juchong/ADIS16448-RoboRIO-Teensy-Interface/PCB/ADIS16448 RoboRIO Teensy MXP Breakout RevA BRD.pdf

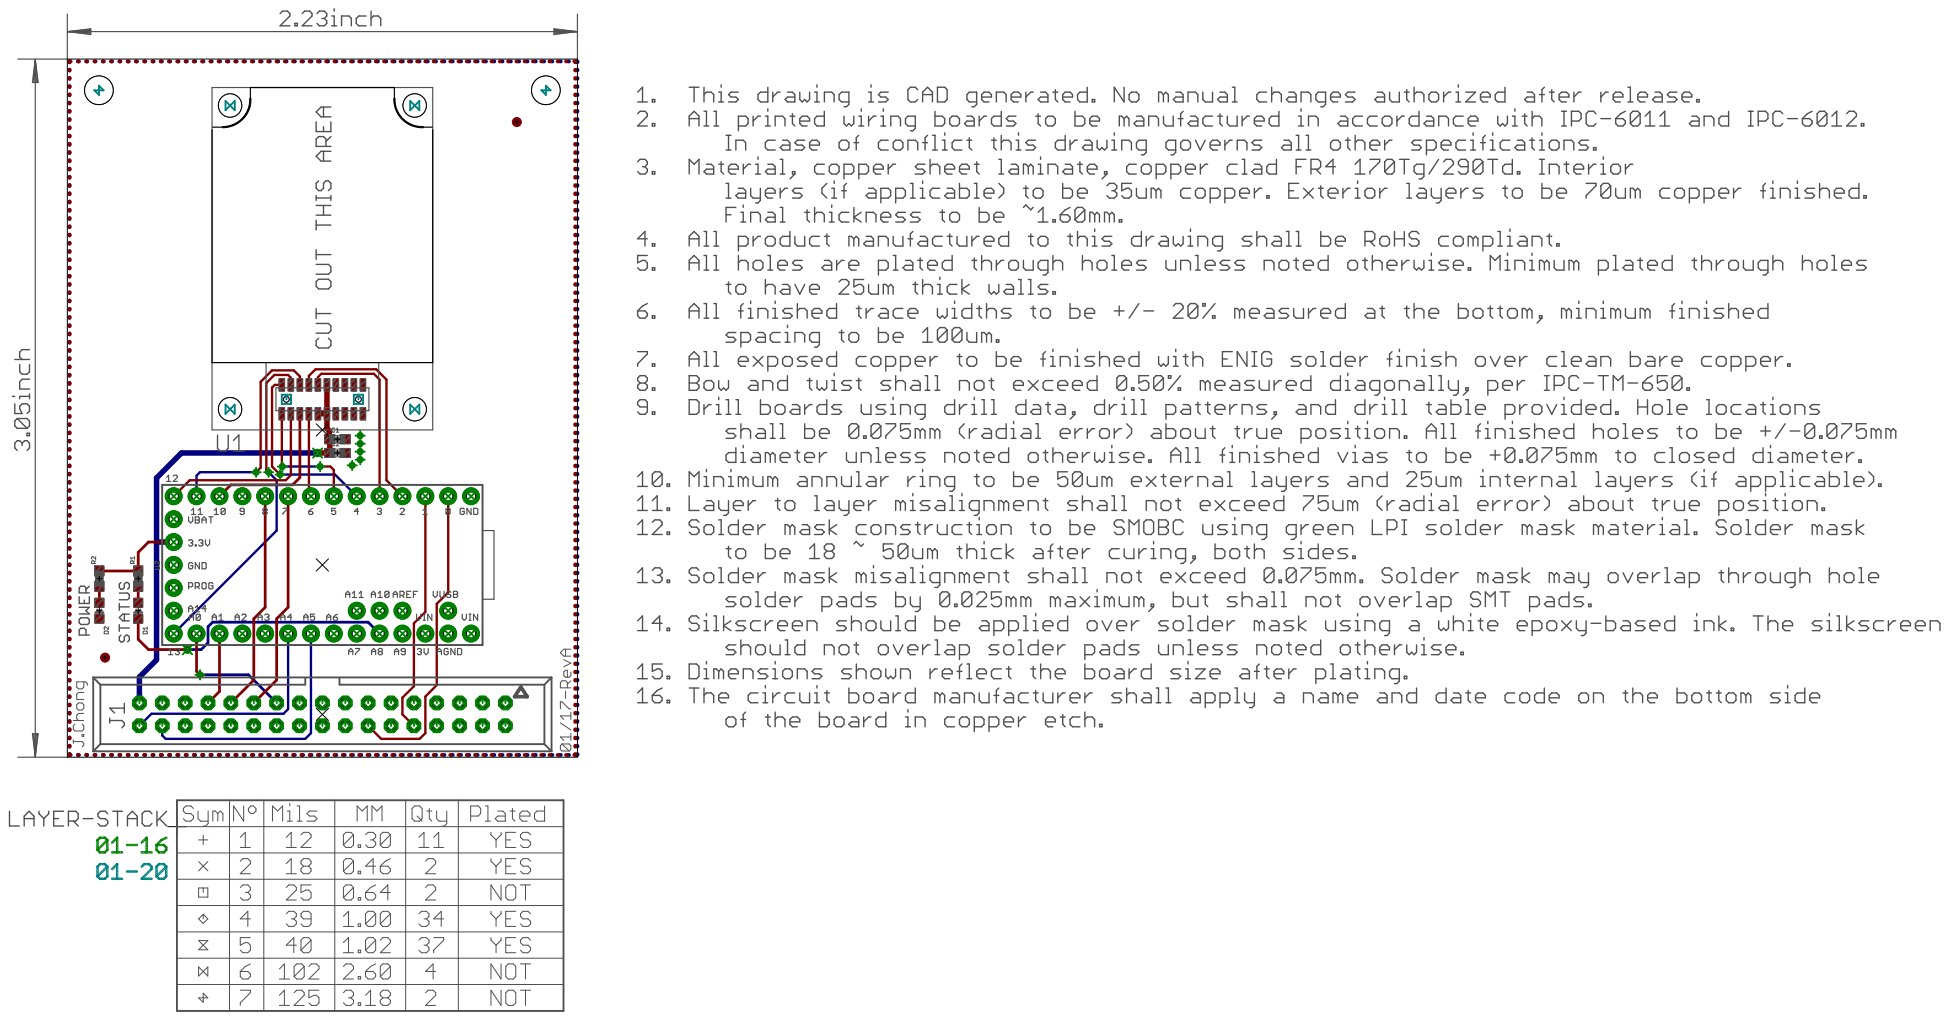
[picture p1: page 1]
