juchong/ADIS16448-RoboRIO-Teensy-Interface/PCB/ADIS16448 RoboRIO Teensy MXP Breakout RevA SCH.pdf

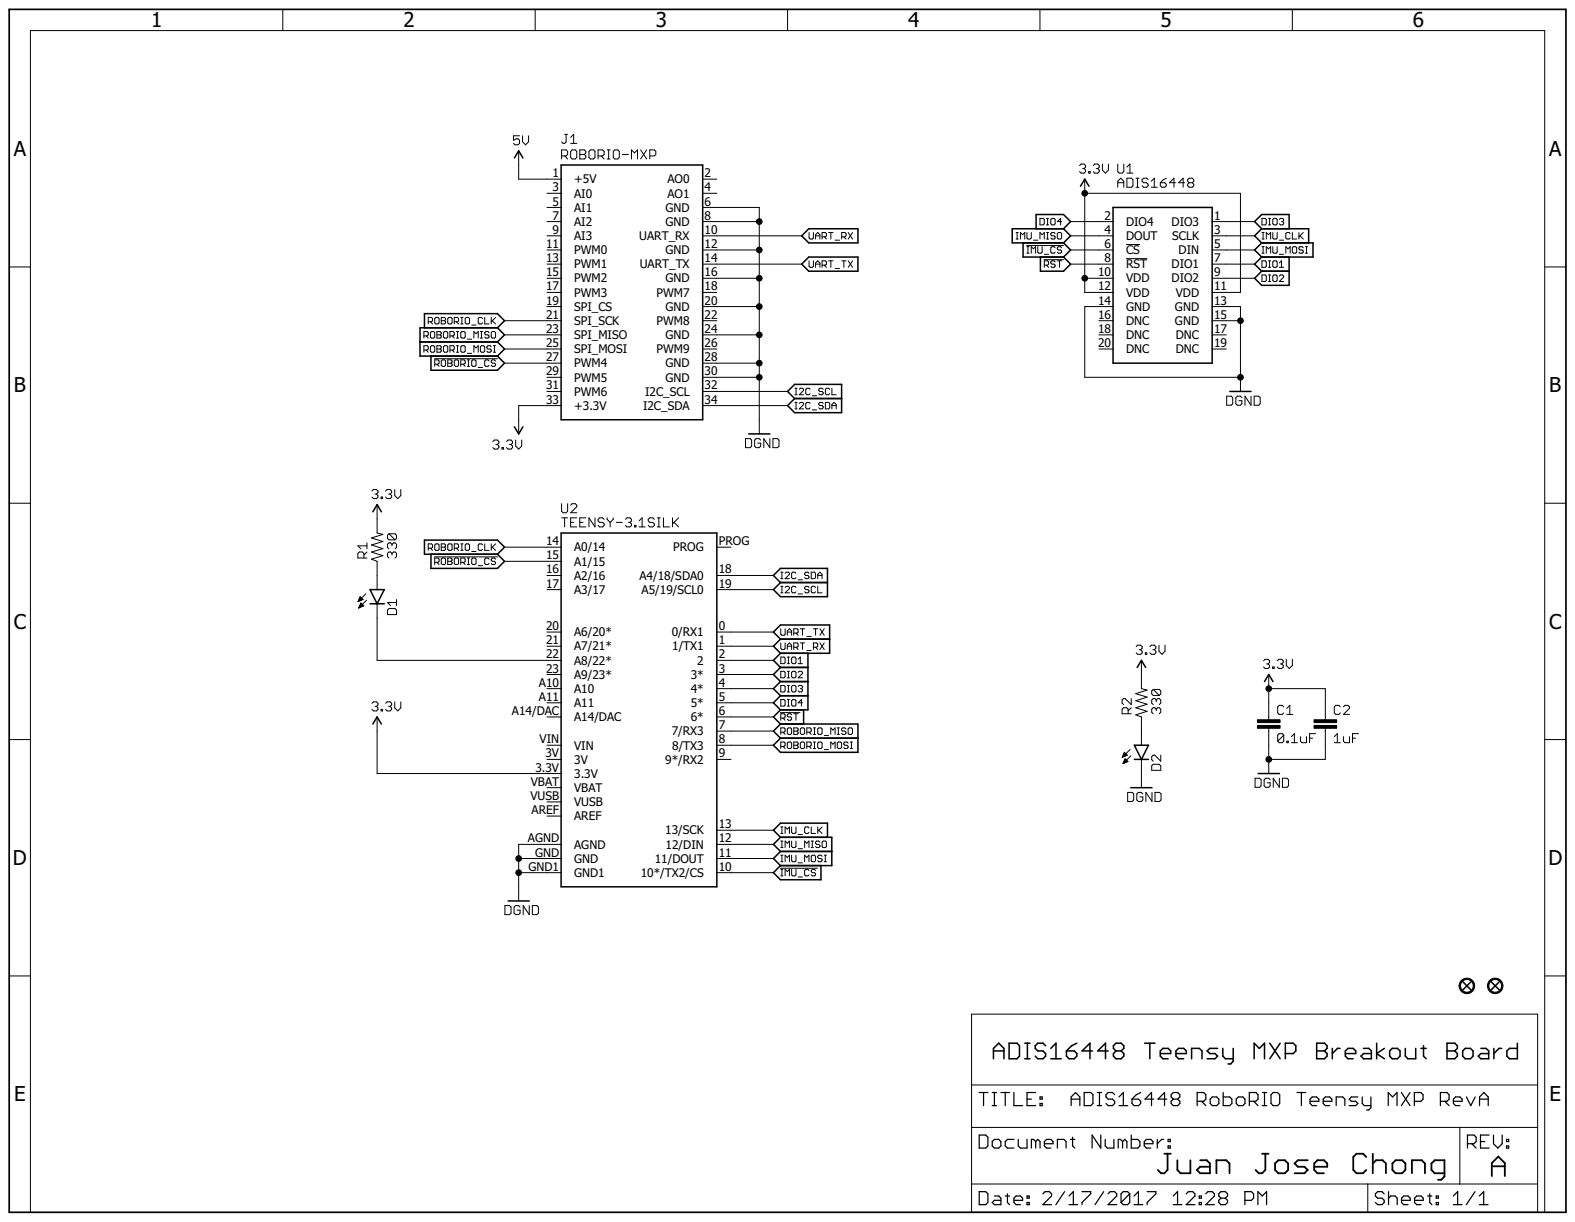
[picture p2: page 1]
