juchong/ADIS16448-RoboRIO-Teensy-Interface/Arduino/ADIS16448_RoboRIO_Teensy_Interface/ADIS16448_RoboRIO_Teensy_Interface.ino

////////////////////////////////////////////////////////////////////////////////////////////////////////
//  February 2017
//  Author: Juan Jose Chong <juan.chong@analog.com>
////////////////////////////////////////////////////////////////////////////////////////////////////////
//  ADIS16448_RoboRIO_Teensy_Interface.ino
////////////////////////////////////////////////////////////////////////////////////////////////////////
// 
//  This Arduino project interfaces an ADIS16448 IMU to a RoboRIO via UART (Serial1). 
//  The Arduino software provides a means of extracting IMU data while precicely controlling 
//  software timing. In addition, this software greatly reduces the processing overhead
//  required to acquire and calculate heading using only the RoboRIO. Gyro offset calibration
//  and heading reset are currently supported using ASCII serial commands sent via serial. 
//
//  This library relies on the ADIS16448 Arduino Teensy library which may be found
//  here: https://github.com/juchong/ADIS16448-Arduino-Teensy
//
//  It also relies on the Madgwick AHRS implementation which may be found here:
//  https://github.com/arduino-libraries/MadgwickAHRS
//	
//	Saving data to EEPROM relies on the EEPROMex library found here:
//	https://github.com/thijse/Arduino-EEPROMEx
//
//  This project has been tested on a PJRC 32-Bit Teensy 3.1/3.2 Development Board, 
//  but should be compatible with any other embedded platform with some modification.
//
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
//  Pinout for a Teensy 3.1/3.2 Development Board
//  RST = D6
//  SCK = D13/SCK
//  CS = D10/CS
//  DOUT(MISO) = D12/MISO
//  DIN(MOSI) = D11/MOSI
//  DR = D2
//	UART RX = D0
//	UART TX = D1
//
////////////////////////////////////////////////////////////////////////////////////////////////////////
#include <ADIS16448.h>
#include <MadgwickAHRS.h>
#include <SimpleGyroIntegrator.h>
#include <SPI.h>
#include <EEPROMex.h>

// Uncomment to enable debug mode and print additional data to the serial port
//#define DEBUG

// Uncomment to overwrite garbage data in EEPROM with 0's
//#define FIRSTRUN

// Change printing from Serial1 (pins 0,1) to Serial (USB)
#define HWSERIAL Serial1

// Initialize data variables
int16_t *burstData;
float scaledData[11];
float pitch, roll, yaw, xdelta, ydelta, zdelta;
float datapacket1[17];
float datapacket2[17];
String serialpacket = "";
String separator = ',';
bool pingpong = true;
bool freezepingpong = false;

// Initialize calibration registers
float calDataX, calDataY, calDataZ = 0;
int calCounter = 0;

// EEPROM initialization
int calXloc = 0;
int calYloc = 5;
int calZloc = 10;

// Delay counter variable
int printCounter = 0;

// Z mounting orientation
bool initOrientation = true; //true = ZUP, false = ZDOWN

// Program flags
int internalCalFlag = 0;
int resetGyroFlag = 0;
bool teensyCalFlag = false;

// Delta time variables
unsigned long oldtime = 0;
unsigned long deltat = 0;

// Call ADIS16448 Class
ADIS16448 IMU(10,2,6); // Chip Select, Data Ready, Reset, Pin Assignments

// Call Madgwick Class
Madgwick AHRS;

// Call Gyro Integrator Class
SimpleGyroIntegrator SGI;

// Initial configuration and initialization
void setup() {
  HWSERIAL.begin(115200);
  IMU.configSPI();
  IMU.regWrite(MSC_CTRL, 0x06);  // Enable Data Ready, set polarity
  delay(20); 
  IMU.regWrite(SENS_AVG, 0x402); // Set digital filter
  delay(20);
  IMU.regWrite(SMPL_PRD, 0x01), // Disable decimation, enable internal sample clock
  delay(20);

// Overwrite EEPROM locations with 0's if this is the first time this code has run on this Teensy
  #ifdef FIRSTRUN
  	EEPROM.writeFloat(calXloc,calDataX);
    EEPROM.writeFloat(calYloc,calDataY);
    EEPROM.writeFloat(calZloc,calDataZ);
  #else
	calDataX = EEPROM.readFloat(calXloc);
	calDataY = EEPROM.readFloat(calYloc);
	calDataZ = EEPROM.readFloat(calZloc);
  #endif

  attachInterrupt(2, grabData, RISING); // Attach interrupt to pin 2. Trigger on the rising edge

}

// Read data from the sensor using burst mode, scale data, and update SGI/AHRS loops. Check for cal flags before reading next frame of data.
void grabData() {

	if (internalCalFlag == 1) {
		calibrateOffsetRegisterIMU();
	}

  // If a calibration is triggered, skip calculations and only service the calibration accumulation
	if (teensyCalFlag == true) {
	    calibrateTeensy();
	}
	else {
    burstData = IMU.burstRead(); // Read data and insert into array
    scaleData(); // Scale IMU data
    
    // Calculate delta time from last interrupt
    deltat = micros() - oldtime; 
    if (deltat > 2000) { // Check for micros() rollover and correct - dirty, but works
      deltat = 1025;
    }
    oldtime = micros(); // Update delta time variable for next iteration
    
    // Integrate gyros over time
    SGI.update(scaledData[0], scaledData[1], scaledData[2], deltat, resetGyroFlag); 
    
    // Compensate for IMU orientation (IMU is mounted upside-down when on an MXP breakout board)
    if (initOrientation == true) {
      AHRS.update(scaledData[0], scaledData[1], scaledData[2], scaledData[3], scaledData[4], scaledData[5], scaledData[6], scaledData[7], scaledData[8], deltat); // Calculage Madgwick AHRS
    }
    else {
      AHRS.update(scaledData[0], (scaledData[1] * -1), (scaledData[2] * -1), scaledData[3], (scaledData[4] * -1), (scaledData[5] * -1), scaledData[6], (scaledData[7] * -1), (scaledData[8] * -1), deltat); // Calculage Madgwick AHRS
    }
    
    // Gather packet data
    pitch = AHRS.getPitch();
    roll = AHRS.getRoll();
    yaw = AHRS.getYaw();
    xdelta = SGI.getX();
    ydelta = SGI.getY();
    zdelta = SGI.getZ();
    
    // PingPong between arrays such that data is not overwritten when writing 
    //  to the serial port while an ISR is generated. Disabling the ISR is not 
    //  acceptable because data would potentially be lost when ISRs weren't serviced.

    // Ping array
    if(pingpong == true) {
      datapacket1[0] = pitch;
      datapacket1[1] = roll;
      datapacket1[2] = yaw;
      datapacket1[3] = xdelta;
      datapacket1[4] = ydelta;
      datapacket1[5] = zdelta;
      datapacket1[6] = scaledData[0];
      datapacket1[7] = scaledData[1];
      datapacket1[8] = scaledData[2];
      datapacket1[9] = scaledData[3];
      datapacket1[10] = scaledData[4];
      datapacket1[11] = scaledData[5];
      datapacket1[12] = scaledData[6];
      datapacket1[13] = scaledData[7];
      datapacket1[14] = scaledData[8];
      datapacket1[15] = scaledData[9];
      datapacket1[16] = scaledData[10];
    }

    // Pong array
    if(pingpong == false) {
      datapacket2[0] = pitch;
      datapacket2[1] = roll;
      datapacket2[2] = yaw;
      datapacket2[3] = xdelta;
      datapacket2[4] = ydelta;
      datapacket2[5] = zdelta;
      datapacket2[6] = scaledData[0];
      datapacket2[7] = scaledData[1];
      datapacket2[8] = scaledData[2];
      datapacket2[9] = scaledData[3];
      datapacket2[10] = scaledData[4];
      datapacket2[11] = scaledData[5];
      datapacket2[12] = scaledData[6];
      datapacket2[13] = scaledData[7];
      datapacket2[14] = scaledData[8];
      datapacket2[15] = scaledData[9];
      datapacket2[16] = scaledData[10];
    }
    // Continue ping-pong-ing until frozen
    if(freezepingpong == false) {
      pingpong = !pingpong;
    }

    // Clear reset gyro flag after reset has been performed
    if (resetGyroFlag == 1) {
      resetGyroFlag = 0;
    }
	}
}

// Function used to scale all acquired data (scaling functions are included in ADIS16448.cpp)
void scaleData() {
    scaledData[0] = IMU.gyroScale(*(burstData + 1)); //Scale X Gyro
    scaledData[1] = IMU.gyroScale(*(burstData + 2)); //Scale Y Gyro
    scaledData[2] = IMU.gyroScale(*(burstData + 3)); //Scale Z Gyro
    scaledData[3] = IMU.accelScale(*(burstData + 4)); //Scale X Accel
    scaledData[4] = IMU.accelScale(*(burstData + 5)); //Scale Y Accel
    scaledData[5] = IMU.accelScale(*(burstData + 6)); //Scale Z Accel
    scaledData[6] = IMU.magnetometerScale(*(burstData + 7)); //Scale X Mag
    scaledData[7] = IMU.magnetometerScale(*(burstData + 8)); //Scale Y Mag
    scaledData[8] = IMU.magnetometerScale(*(burstData + 9)); //Scale Z Mag
    scaledData[9] = IMU.pressureScale(*(burstData + 10)); //Scale Pressure Sensor
    scaledData[10] = IMU.tempScale(*(burstData + 11)); //Scale Temp Sensor

    // Subtract offsets from gyro signals
    scaledData[0] = scaledData[0] - calDataX;
    scaledData[1] = scaledData[1] - calDataY;
    scaledData[2] = scaledData[2] - calDataZ;
}

void calibrateTeensy() {
  burstData = IMU.burstRead(); // Read data and insert into array
  scaleData(); // Scale IMU data
  // Accumulate offset data
  calDataX = scaledData[0] + calDataX;
  calDataY = scaledData[1] + calDataY;
  calDataZ = scaledData[2] + calDataZ;
  calCounter = calCounter + 1;
  // 8192 = 10 seconds of data capture
  if (calCounter >= 8192) {
  	// Write data to EEPROM, clear flags
    EEPROM.writeFloat(calXloc,calDataX);
    EEPROM.writeFloat(calYloc,calDataY);
    EEPROM.writeFloat(calZloc,calDataZ);
    teensyCalFlag = false;
    calCounter = 0;
  }
}

// IMU built-in calibration routine
void calibrateOffsetRegisterIMU() {
  detachInterrupt(2); //Detach interrupt to avoid overwriting data
  HWSERIAL.println("Make sure the sensor is in a stable position!");
  HWSERIAL.print("Starting in ");
  HWSERIAL.print("5... ");
  delay(1000);
  HWSERIAL.print("4... ");
  delay(1000);
  HWSERIAL.print("3... ");
  delay(1000);
  HWSERIAL.print("2... ");
  delay(1000);
  HWSERIAL.println("1... ");
  delay(1000);
  HWSERIAL.println("Recording data. This will take ~25 Seconds. Do not move the sensor!");
  IMU.regWrite(SENS_AVG, 0x102); // Set gyro range to 250dps
  delay(50);
  IMU.regWrite(SMPL_PRD, 0xE01); //Set averaging to ~25 seconds
  for(int i = 0; i < 25; i++) {
    HWSERIAL.print(".");
    delay(1000);
  }  
  IMU.regWrite(GLOB_CMD,0x01); // Write offset data to offset registers
  delay(50);
  IMU.regWrite(SMPL_PRD,0x01); // Set sample period to 819.2SPS
  delay(50);
  IMU.regWrite(GLOB_CMD,0x08); // Write configuration to IMU flash
  delay(500);
  IMU.regWrite(GLOB_CMD,0x80); // Software reset IMU
  delay(1000);
  IMU.regWrite(SENS_AVG,0x402); // Set range to 2000dps
  delay(50);
  IMU.regWrite(GLOB_CMD,0x08); // Write configuration to IMU flash
  delay(1000);
  HWSERIAL.println(" ");
  HWSERIAL.println("Offsets have been recorded! Here's what was written to the sensor:");
  int16_t xgoffset = IMU.regRead(XGYRO_OFF);
  int16_t ygoffset = IMU.regRead(YGYRO_OFF);
  int16_t zgoffset = IMU.regRead(ZGYRO_OFF);
  HWSERIAL.print("XGYRO_OFF: ");
  HWSERIAL.println(xgoffset);
  HWSERIAL.print("YGYRO_OFF: ");
  HWSERIAL.println(ygoffset);
  HWSERIAL.print("ZGYRO_OFF: ");
  HWSERIAL.println(zgoffset);
  delay(5000);
  internalCalFlag = 0; // Clear cal flag
  attachInterrupt(2, grabData, RISING); // Re-attach interrupt to pin 2. Trigger on the rising edge
}

// Function to act upon serial data received from the host
// Change to serialEvent() if using USB
// Change to serialEvent1() if using pins 0,1
void serialEvent1() {
  while (HWSERIAL.available()) {
    char inChar = (char)HWSERIAL.read();
    if (inChar == 'c') {
      internalCalFlag = 1;
    }
    if (inChar == 'r') {
      resetGyroFlag = 1;
    }
    if (inChar == 'u') {
    	initOrientation = true;
    }
    if (inChar == 'd') {
    	initOrientation = false;
    }
    if (inChar == 'a') {
      teensyCalFlag = true;
    }
  }
}

void loop() {
  printCounter ++;
  if (printCounter >= 10000) // Delay for writing data to the serial port
  {
    // Build data packet for frame from either ping or pong. Note that
    //  whichever array is active, it will never be overwritten by servicing ISRs.
    freezepingpong = true;
    // Ping active
    if(pingpong == true) {
      for(int x = 0; x < 17; x++) {
        serialpacket += String(datapacket1[x],4);
        serialpacket += separator;
      }
    }
    // Pong active
    if(pingpong == false) {
      for(int x = 0; x < 17; x++) {
        serialpacket += String(datapacket2[x],4);
        serialpacket += separator;
      }
    }
  
    // Print data packet to serial port
    HWSERIAL.println(serialpacket);

    // Debug routines for testing
    #ifdef DEBUG
      HWSERIAL.println(calDataX);
      HWSERIAL.println(calDataY);
      HWSERIAL.println(calDataZ);
    #endif

    // Clear data packet
    serialpacket = "";

    // Unfreeze pingpong
    freezepingpong = false;
    
    // Reset print counter
    printCounter = 0;
  }
}
