juchong/ADIS16448-RoboRIO-Teensy-Interface/(commit log)

2017-01-08 Initial commit. Code is working correctly, but lacks communication to the RoboRIO.
    [ADIS16448_RoboRIO_Teensy_Interface.ino]
2017-01-09 Added a USB serial and HW serial version of the arduino code. Built a skeleton library to read data using a RoboRIO.
2017-01-15 Fixed a bug where characters were not read from the serial port in Serial1 mode. Updated the LabVIEW code with a proper example and full FGV support.
    [ADIS16448_RoboRIO_Teensy_Interface_HWSerial.ino]
2017-01-15 Added support for mounting the IMU in the ZDOWN orientation and modifying the AHRS algorithm upon startup. Improved example.
2017-01-27 Merged the HW and SW Arduino sketches, added a "Teensy" calibration routine, and integrated EEPROM calibration saving.
2017-02-12 Added support for triggering calibration from LabVIEW
2017-02-16 Updated driver to output all burst data to the serial port.
2017-02-16 Changed data packet to build in the ISR to avoid transmitting bad data.
    [ADIS16448_RoboRIO_Teensy_Interface.ino]
2017-02-16 Implemented register ping/pong to prevent overwriting data while transmitting over serial.
    [ADIS16448_RoboRIO_Teensy_Interface.ino]
2017-02-17 Added schematic and layout to the project
2017-02-23 Correctly converting floats to strings with 4 decimals.
    [ADIS16448_RoboRIO_Teensy_Interface.ino]
